calliope-mini/calliope-mini.github.io/README.md

# Technical Documentation

[see here](https://calliope-mini.github.io)
