calliope-mini/calliope-mini.github.io/hardware/v3.0/v30.md

---
layout: page
title: v3.0
permalink: v30/
navigation_weight: 2
---

## Allgemeines

Der Calliope mini 3 erhält nun schnellere Prozessoren, USB-C, 3 RGB-LED, einen besseren Motortreiber, Jacdac Konnektoren, sowie eine Pinleite.

### Technische Spezifikation  
  
* [Nordic nRF52833](https://www.nordicsemi.com/Products/nRF52833) Multi-protocol Bluetooth® low energy/2.4GHz RF SoC
    + 64MHZ ARM Cortex M4
    + 128kB RAM
    + 512kB Flash
    + Bluetooth Low Energy 5.4
* [Nordic nRF52820](https://www.nordicsemi.com/Products/nRF52820)
* 5x5 LED Matrix Bildschirm  
* Beschleunigungssensor, Gyroskop, Magnetometer
* MEMS Mikrofon
* DC Motortreiber ([TI DRV8835](http://www.ti.com/product/DRV8835))
* Piezo-Lautsprecher (MLT-8530)
* 3 Programmierbare RGB-LED
* 2 programmierbare Taster
* Serielle Schnittstelle (USB + konfigurierbare Anschlüsse)
* 2 Jacdac Konnektoren
* PWM Ausgabe
* 4 ansteckbare Laborstecker-Pins (Bananenstecker-/Krokodilklemmenanschlüsse)
* SPI + I2C
* USB-C Anschluss (Programmierung und Stromversorgung)
* 2x15 Pinleiste (2,54mm Lochraster)
* JST PH 2.0 Batterieanschluss (3.3V)
* Bananen-/Krokodilklemmenanschluss für 3.3V (Ausgang)
* 2 [Grove](http://wiki.seeed.cc/Grove_System/) Steckverbinder (I2C + Seriell/Analog)

### Software

#### Quellen und Entwicklungsumgebungen

- [Software Repository](https://github.com/calliope-edu){:target="_blank"}, enthält die offiziellen Calliope mini Softwareprojekte.
- MakeCode ([online Entwicklungsumgebung](https://makecode.calliope.cc))
- Python ([online Entwicklungsumgebung](https://python.calliope.cc))

### Pinbelegung

Pinbelegung (https://calliope.cc/media/pages/calliope-mini/technische-daten/6b2510621e-1695728195/calliopev3_front.svg){:target="_blank"}

### Schaltplan

[PDF](../assets/v30/img/Calliope_mini_3.pdf){:target="_blank"}

[License](../assets/img/calliope_license.png)
