calliope-mini/calliope-mini.github.io/index.md

---
layout: home
permalink: index.html
navigation_weight: 0
---
# CALLIOPE MINI

Der [Calliope mini](https://calliope.cc) ist eine für die Schule entwickelte Lernplattform.

Auf dieser Seite werden vorrangig technische Informationen zum Projekt bereitgestellt.
Sonstige Informationen, wie Materialien, Kontakt etc. finden sich unter [calliope.cc](https://calliope.cc).

Calliope
