calliope-mini/calliope-mini.github.io/hardware/v2.1/v21.md

---
layout: page
title: v2.1
permalink: v21/
navigation_weight: 2
---

## Allgemeines

Aufgrund der veränderten Verfügbarkeit von Bauteilen, wurden an der Version 2.0 geringe Hardwareveränderungen vorgenommen. Diese überarbeitete Version trägt die Nummer 2.1.
Die Arbeitsweise und der Funktionsumfang zur Version 2.0 haben sich nicht geändert.

### Technische Spezifikation  
  
* [Nordic nRF51822](https://www.nordicsemi.com/eng/Products/Bluetooth-low-energy/nRF51822) Multi-protocol Bluetooth® 4.0 low energy/2.4GHz RF SoC
    + 32-bit ARM Cortex M0 processor (16MHz)
    + 32kB RAM
    + 256kB Flash
    + Bluetooth Low Energy 
* [Raspberry Pi RP2040](https://www.raspberrypi.com/products/rp2040/) Dual-core Arm Cortex-M0+ Prozessor, mit bis zu 133MHz
* Flash Speicher 128Mb, 166MHZ ([ISSI IS25LP](http://www.issi.com/WW/pdf/25LP-WP128F.pdf)), frei bespielbar und ohne angeschlossenen Computer nutzbar
* 5x5 LED Matrix Bildschirm  
* Beschleunigungssensor, Gyroskop, Magnetometer ([Bosch BMX055](https://www.bosch-sensortec.com/bst/products/all_products/bmx055))
* MEMS Mikrofon
* DC Motortreiber ([TI DRV8837](http://www.ti.com/product/DRV8837))
* Piezo-Lautsprecher (MLT-8530)
* Programmierbare RGB LED ([WS2812b](https://cdn-shop.adafruit.com/datasheets/WS2812B.pdf))
* 2 programmierbare Taster
* Serielle Schnittstelle (USB + konfigurierbare Anschlüsse)
* PWM Ausgabe
* 4 ansteckbare Laborstecker-Pins (Bananenstecker-/Krokodilklemmenanschlüsse)
* 4 Analoge Eingänge
* 8-11 Ein-/Ausgangsanschlüsse (je nach Softwarekonfiguration)
* SPI + I2C
* USB Micro B Anschluss (Programmierung und Stromversorgung)
* JST PH 2.0 Batterieanschluss (3.3V)
* Bananen-/Krokodilklemmenanschluss für 3.3V (Ausgang)
* 2 [Grove](http://wiki.seeed.cc/Grove_System/) Steckverbinder (I2C + Seriell/Analog)

### Software

#### Quellen und Entwicklungsumgebungen

- [Software Repository](https://github.com/calliope-mini){:target="_blank"}, enthält die offiziellen Calliope mini Softwareprojekte.
- [OpenRoberta](https://github.com/OpenRoberta) ([online Entwicklungsumgebung](https://lab.open-roberta.org/))
- MakeCode ([online Entwicklungsumgebung](https://makecode.calliope.cc))

#### Standard Firmware

* [Firmware](https://github.com/calliope-mini/calliope-demo/releases/tag/3.1.0), Software, die sich im Auslieferungszustand auf
dem Gerät befindet.

### Pinbelegung

Pinbelegung{:target="_blank"}

### Blockschaltbild

Blockschaltbild Calliope mini v1.0{:target="_blank"}

### Schaltplan

[PDF](../assets/v21/img/Calliope mini rev2.1.pdf){:target="_blank"}, 
PNG ([Seite 1](../assets/v21/img/Calliope mini rev2.1.png){:target="_blank"}, [Seite 2](../assets/v21/img/Calliope mini rev2.1-2.png){:target="_blank"}),
(Eagle [SCH](../assets/v21/eagle/Calliope mini rev2.1.sch), [BRD](../assets/v21/eagle/Calliope mini rev2.1.brd))

Schaltplan Calliope mini v2.1 (Seite 1){:target="_blank"}
Schaltplan Calliope mini v2.1 (Seite 2){:target="_blank"}

[License](../assets/img/calliope_license.png)
