calliope-mini/calliope-mini.github.io/hardware/v1.0/v10.md

---
layout: page
title: v1.3
permalink: v10/
navigation_weight: 2
---

## Allgemeines

Die Revision 1.3 ist eine überarbeitete Version des Calliope mini. Wichtige Änderungen sind der Austausch 
der Taster mit den Grove Anschlüssen, so dass diese besser bedient werden können. Ausserdem wurden auf den
Grove Anschlüssen zwei Analoge Eingänge verfügbar gemacht. Zusätzlich wurde eine verbesserter Schutz gegen
elektrostatische Entladung eingebracht. Der Logoaufdruck befindet sich hier auf der linken Seite
der Platine auf der Antenne. Mit der v1.3 wurde eine weitere Masseleitung zum Motorport hinzugefügt und die 
Stromversorgung so aktualisiert, dass Batterie und USB bei gleichzeitigem Anschluss getrennt sind.

### Technische Spezifikation  
  
* [Nordic nRF51822](https://www.nordicsemi.com/eng/Products/Bluetooth-low-energy/nRF51822) Multi-protocol Bluetooth® 4.0 low energy/2.4GHz RF SoC
    + 32-bit ARM Cortex M0 processor (16MHz)
    + 16kB RAM
    + 256kB Flash
    + Bluetooth Low Energy 
* 5x5 LED Matrix Bildschirm  
* Beschleunigungssensor, Gyroskop, Magnetometer ([Bosch BMX055](https://www.bosch-sensortec.com/bst/products/all_products/bmx055))
* MEMS Mikrofon
* DC Motortreiber ([TI DRV8837](http://www.ti.com/product/DRV8837))
* Piezo-Lautsprecher
* Programmierbare RGB LED ([WS2812b](https://cdn-shop.adafruit.com/datasheets/WS2812B.pdf))
* 2 programmierbare Taster
* Serielle Schnittstelle (USB + konfigurierbare Anschlüsse)
* PWM Ausgabe
* 4 Bananenstecker-/Krokodilklemmenanschlüsse
* 4 Analoge Eingänge
* 8-11 Ein-/Ausgangsanschlüsse (je nach Softwarekonfiguration)
* SPI + I2C
* USB Micro B Anschluss (Programmierung und Stromversorgung)
* JST Batterieanschluss (3.3V)
* Bananen-/Krokodilklemmenanschluss für 3.3V (Ausgang)
* 2 [Grove](http://wiki.seeed.cc/Grove_System/) Steckverbinder (I2C + Seriell/Analog)
* [NXP KL26z](http://www.nxp.com/products/microcontrollers-and-processors/arm-processors/kinetis-cortex-m-mcus/l-series-ultra-low-power-m0-plus/kinetis-kl2x-48-mhz-usb-ultra-low-p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) (USB und Stromversorgung)
* Flash-Programmspeicher (optional)

### Software

#### Quellen und Entwicklungsumgebungen

- [Software Repository](https://github.com/calliope-mini){:target="_blank"}, enthält die offiziellen Calliope mini Softwareprojekte.
- [OpenRoberta](https://github.com/OpenRoberta) ([online Entwicklungsumgebung](https://lab.open-roberta.org/))
- MakeCode ([online Entwicklungsumgebung](https://pxt.calliope.cc))

#### Standard Firmware

* [Firmware](https://github.com/calliope-mini/calliope-demo/releases/tag/v2.0), Software, die sich im Auslieferungszustand auf
dem Gerät befindet.
* [Bootloader](https://github.com/calliope-mini/production-test/releases/tag/bootloader-r1.0), Software, die auf dem Interface-Chip
läuft und für den Fall aufgespielt wird, wenn sich der Calliope mini nicht mehr mit dem Laufwerk `MINI` anmeldet.

### Pinbelegung

Pinbelegung{:target="_blank"}

### Blockschaltbild

Blockschaltbild Calliope mini v1.0{:target="_blank"}

### Schaltplan

[PDF](../assets/v10/img/Calliope mini rev1.3.pdf){:target="_blank"}, 
PNG ([Seite 1](../assets/v10/img/Calliope mini rev1.3.png){:target="_blank"}, [Seite 2](../assets/v10/img/Calliope mini rev1.3-2.png){:target="_blank"}),
(Eagle [SCH](../assets/v10/eagle/Calliope mini rev1.3.sch), [BRD](../assets/v10/eagle/Calliope mini rev1.3.brd))

Schaltplan Calliope mini v1.3 (Seite 1){:target="_blank"}
Schaltplan Calliope mini v1.3 (Seite 2){:target="_blank"}

### Errata / Fehler

* Die Verbindung von Pin DEC2 und VCC führt zu erhöhtem Stress bei der Nordic nRF51 MCU, da damit der Chip auf 1.8V eingestellt wird. Dieser Fehler in der Schaltung wurde durch eine mechanische Trennung bei allen Geräten behoben, die ab der Crowdfunding Campagne ausgeliefert wurden. (**Ab Version > 1.0 behoben**)
* Die Mikrofonschaltung hat eine sehr geringe Verstärkung. Dieser Fehler wurde durch den Tausch eines Widerstands in der laufenden Produktion behoben. (**Ab Version > 1.0 behoben**) 
* Die Stromversorgung trennt nicht komplett, wenn Batterie und USB angeschlossen sind. Mit Version 1.3 behoben.
