calliope-mini/calliope-mini.github.io/assets/img/calliope_license.png

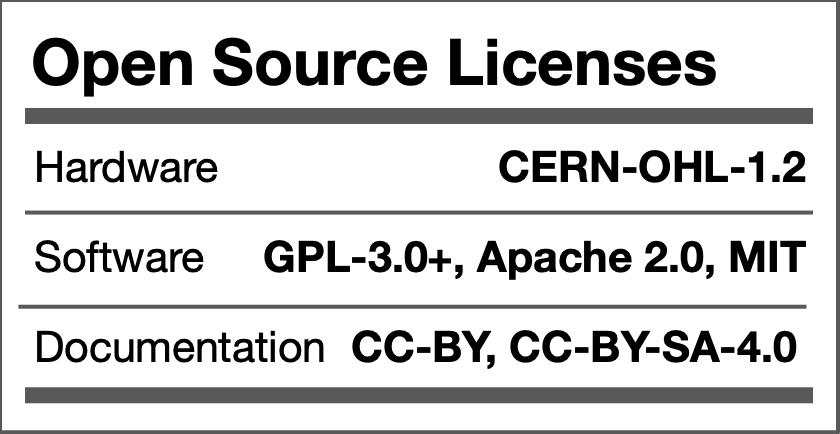
assets/img/calliope_license.png
