calliope-mini/calliope-mini.github.io/(threads)

Thread 1 (2017-04-25):

Preview enlargement not working

Portabella, 2017-04-25:
When I click on the preview enlargement button (Vollbildmodus) below the Calliope Simulator, it only enlarges the button, not the Calliope simulator itself.

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

Thread 2 (2017-04-25):

Shake button is very small

Portabella, 2017-04-25:
In the simulator the shake button is very small. In an older version it was larger and students were able to find it easier. Can you please make the button larger again?

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

Thread 3 (2017-04-25):

In Firefox on music keyboard the name of the note is not shown

Portabella, 2017-04-25:
Remark: Might be an issue only relevant in older versions of Firefox.

If I want to program a song, I do not see the name of the music note. It is not shown below the keyboard. It works in Chrome. See two images attached.
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

Thread 4 (2017-05-20):

Choose a license

Fluepke, 2017-05-20:
What is the license of this project?
Is this truly open source? Can I reuse your code and schematics for my own projects?

thinkberg, 2017-06-12:
The source code has the license individually attached. I will check that we attach a license to the info page as well.

nichtich, 2017-08-20:
Yes, please! Anything against CC0?

tatzelbrumm, 2017-11-05:
Do you have a license for the **hardware**?
Those need to be handled differently than software source code.
Maybe use one of the Open Hardware Licenses from the [Open Hardware Repository](https://www.ohwr.org/licenses), like, [CERN OHL v1.2](https://www.ohwr.org/licenses/cern-ohl/license_versions/v1.2)?

Thread 6 (2019-02-10):

fritzing part

el-j, 2019-02-10:
hej just to let you know:
there is now a fritzing part of the rev 1.3 board:
checkout https://github.com/fritzing/fritzing-parts/issues/171

maybe nice to link as well?
cheers
