calliope-mini/calliope-mini.github.io/assets/v21/img/Calliope mini rev2.1.pdf

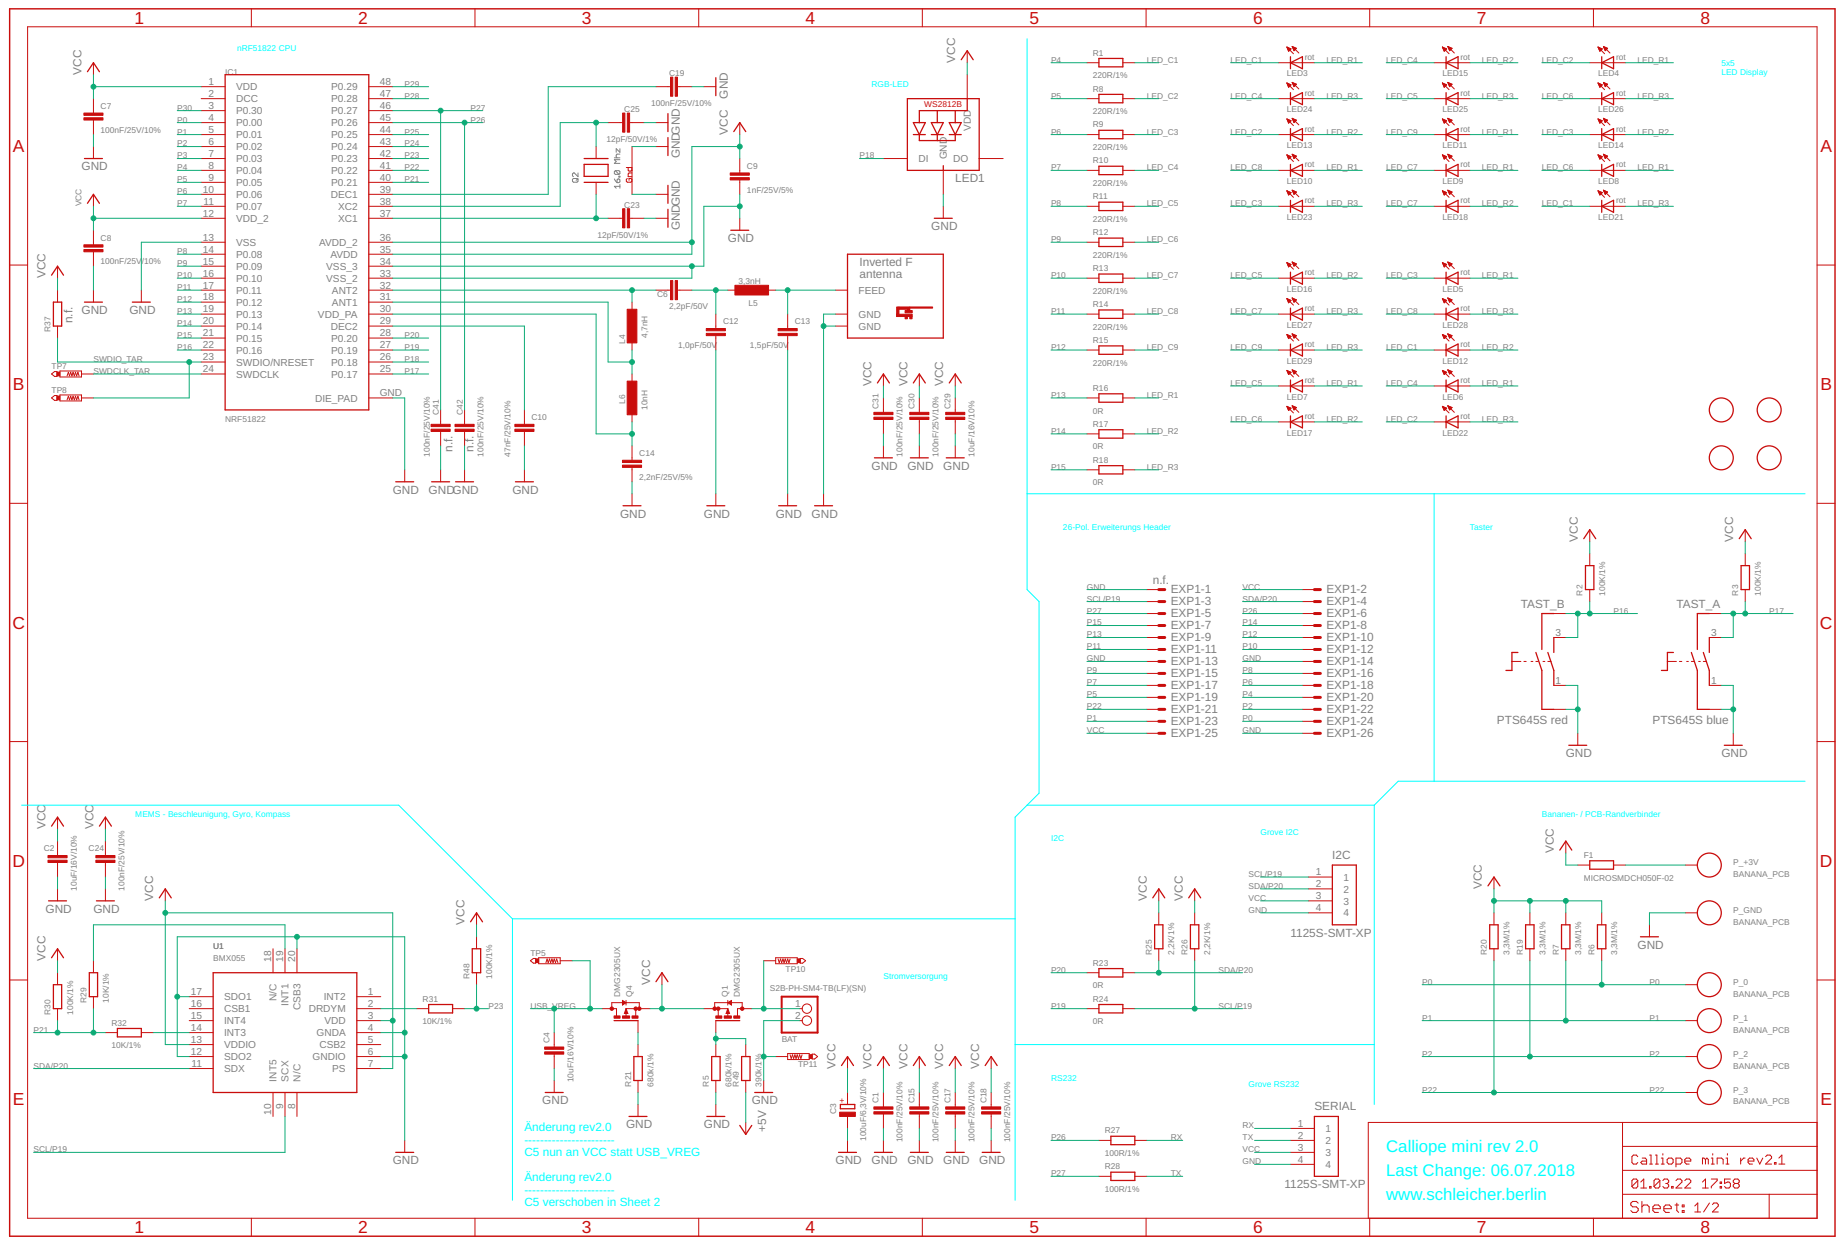
[picture p13: page 1]

MEMS - Beschleunigung, Gyro, Kompass

Änderung rev2.0
----------------------- C5 nun an VCC statt USB_VREG

Calliope mini rev 2.0
Last Change: 06.07.2018 www.schleicher.berlin

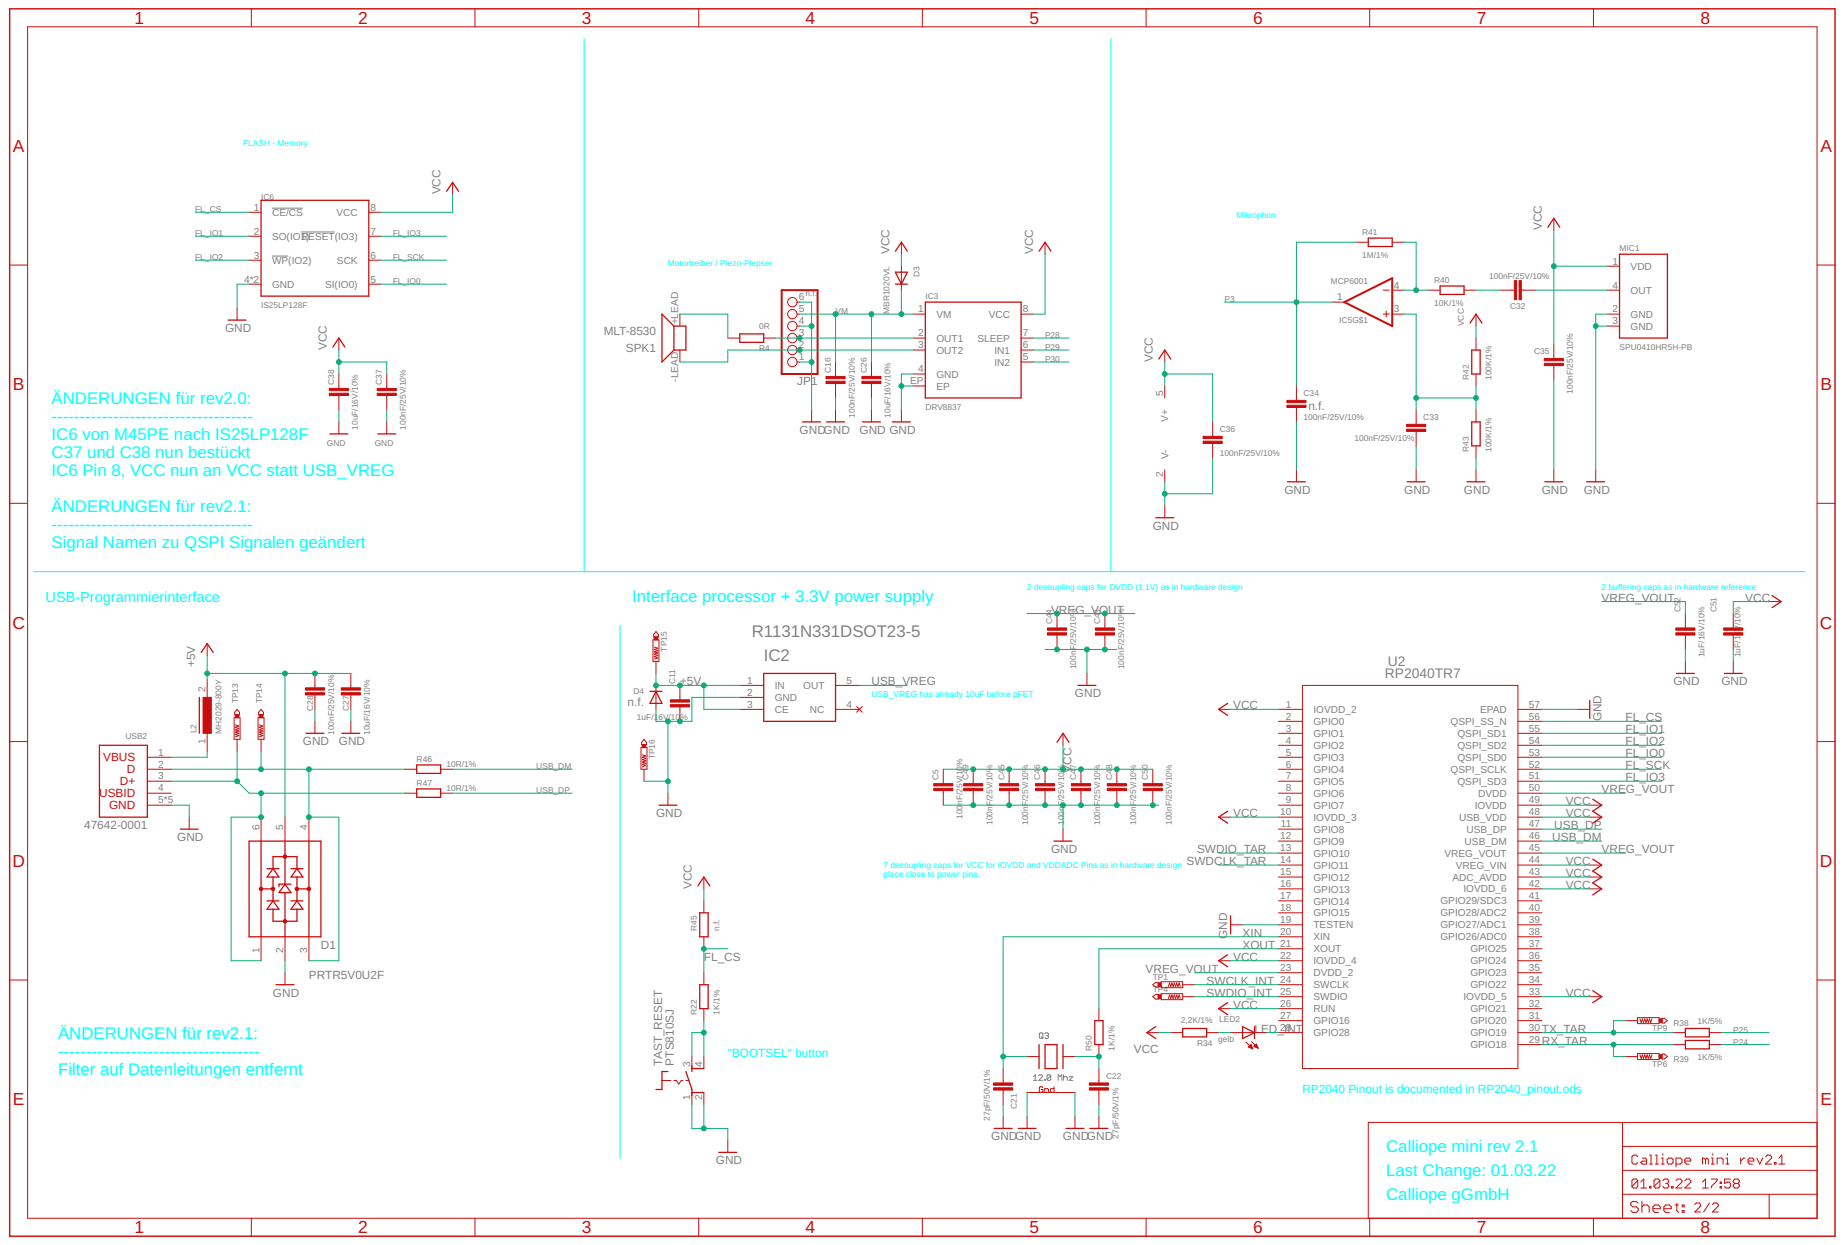
[picture p14: page 2]

VCC GND GND GND

ÄNDERUNGEN für rev2.0: ------------------------------------
IC6 von M45PE nach IS25LP128F
C37 und C38 nun bestückt
IC6 Pin 8, VCC nun an VCC statt USB_VREG
ÄNDERUNGEN für rev2.1: ------------------------------------ Signal Namen zu QSPI Signalen geändert

Interface processor + 3.3V power supply

2 decoupling caps for DVDD (1.1V) as in hardware design

2 buffering caps as in hardware reference

7 decoupling caps for VCC for IOVDD and VDDADC Pins as in hardware design
place close to power pins.

ÄNDERUNGEN für rev2.1: ------------------------------------ Filter auf Datenleitungen entfernt

RP2040 Pinout is documented in RP2040_pinout.ods
