calliope-mini/calliope-mini.github.io/assets/v20/img/Calliope mini rev2.0.pdf

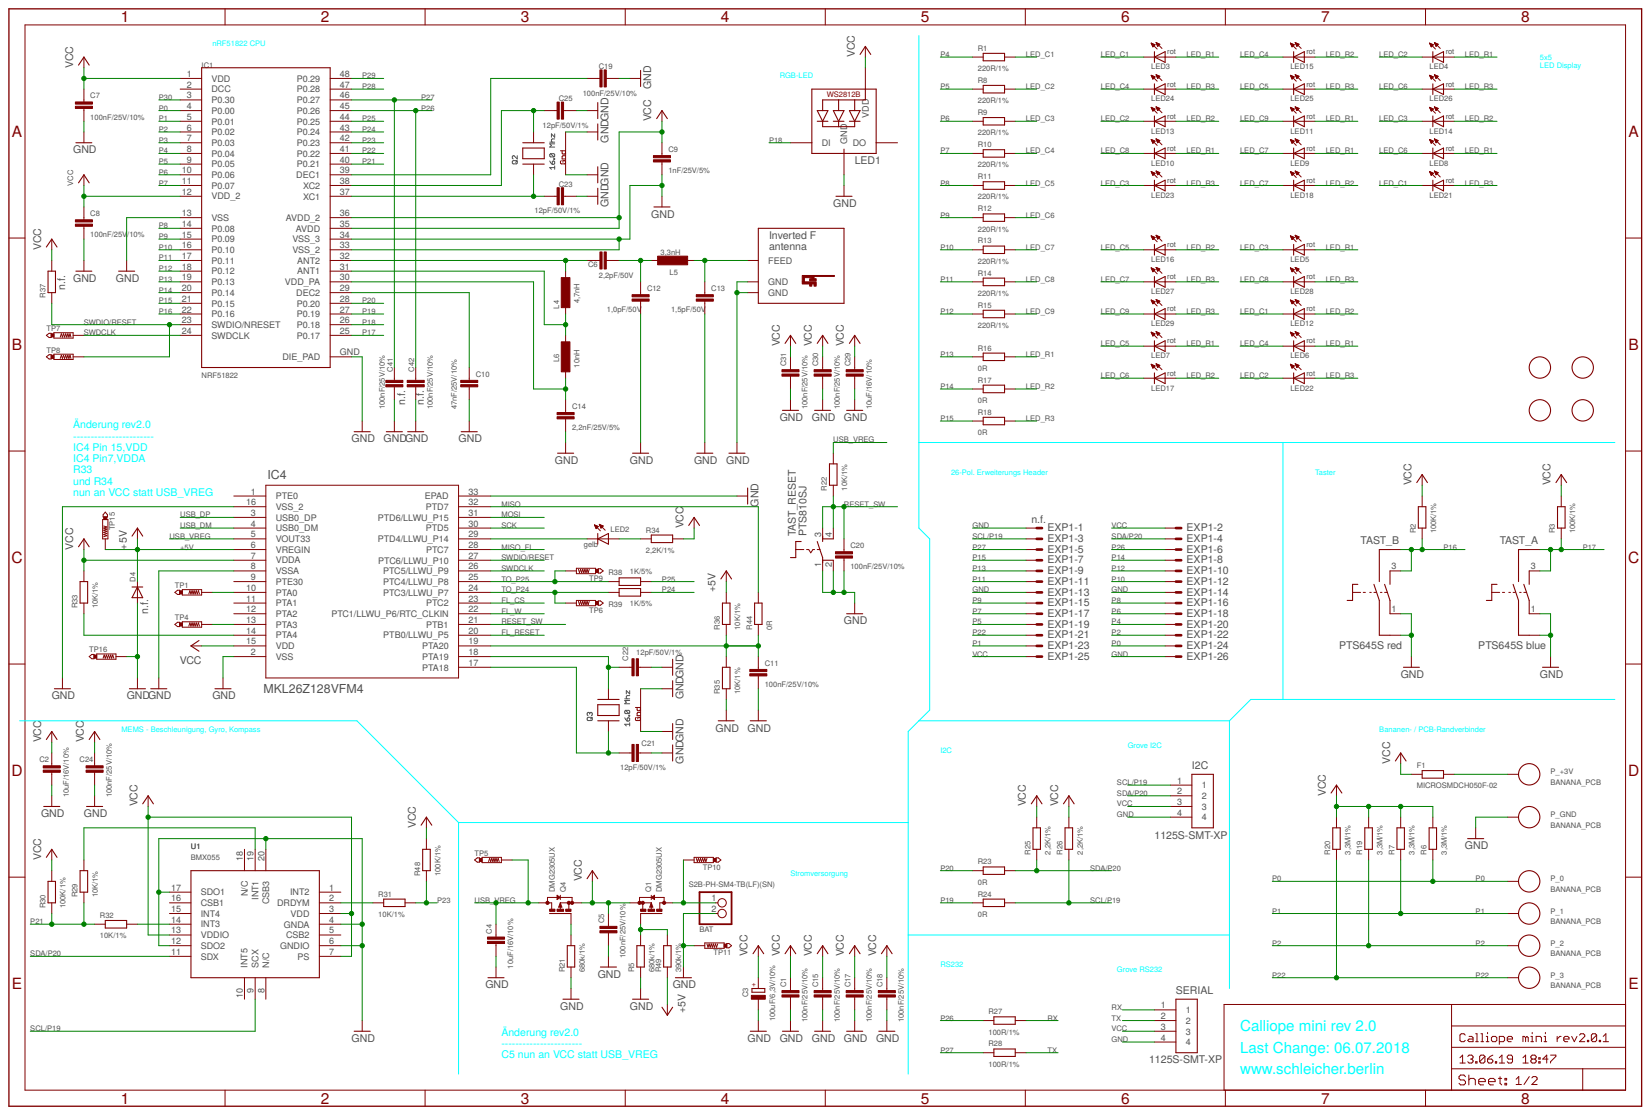
[picture p15: page 1]

MEMS - Beschleunigung, Gyro, Kompass

Änderung rev2.0
----------------------- C5 nun an VCC statt USB_VREG

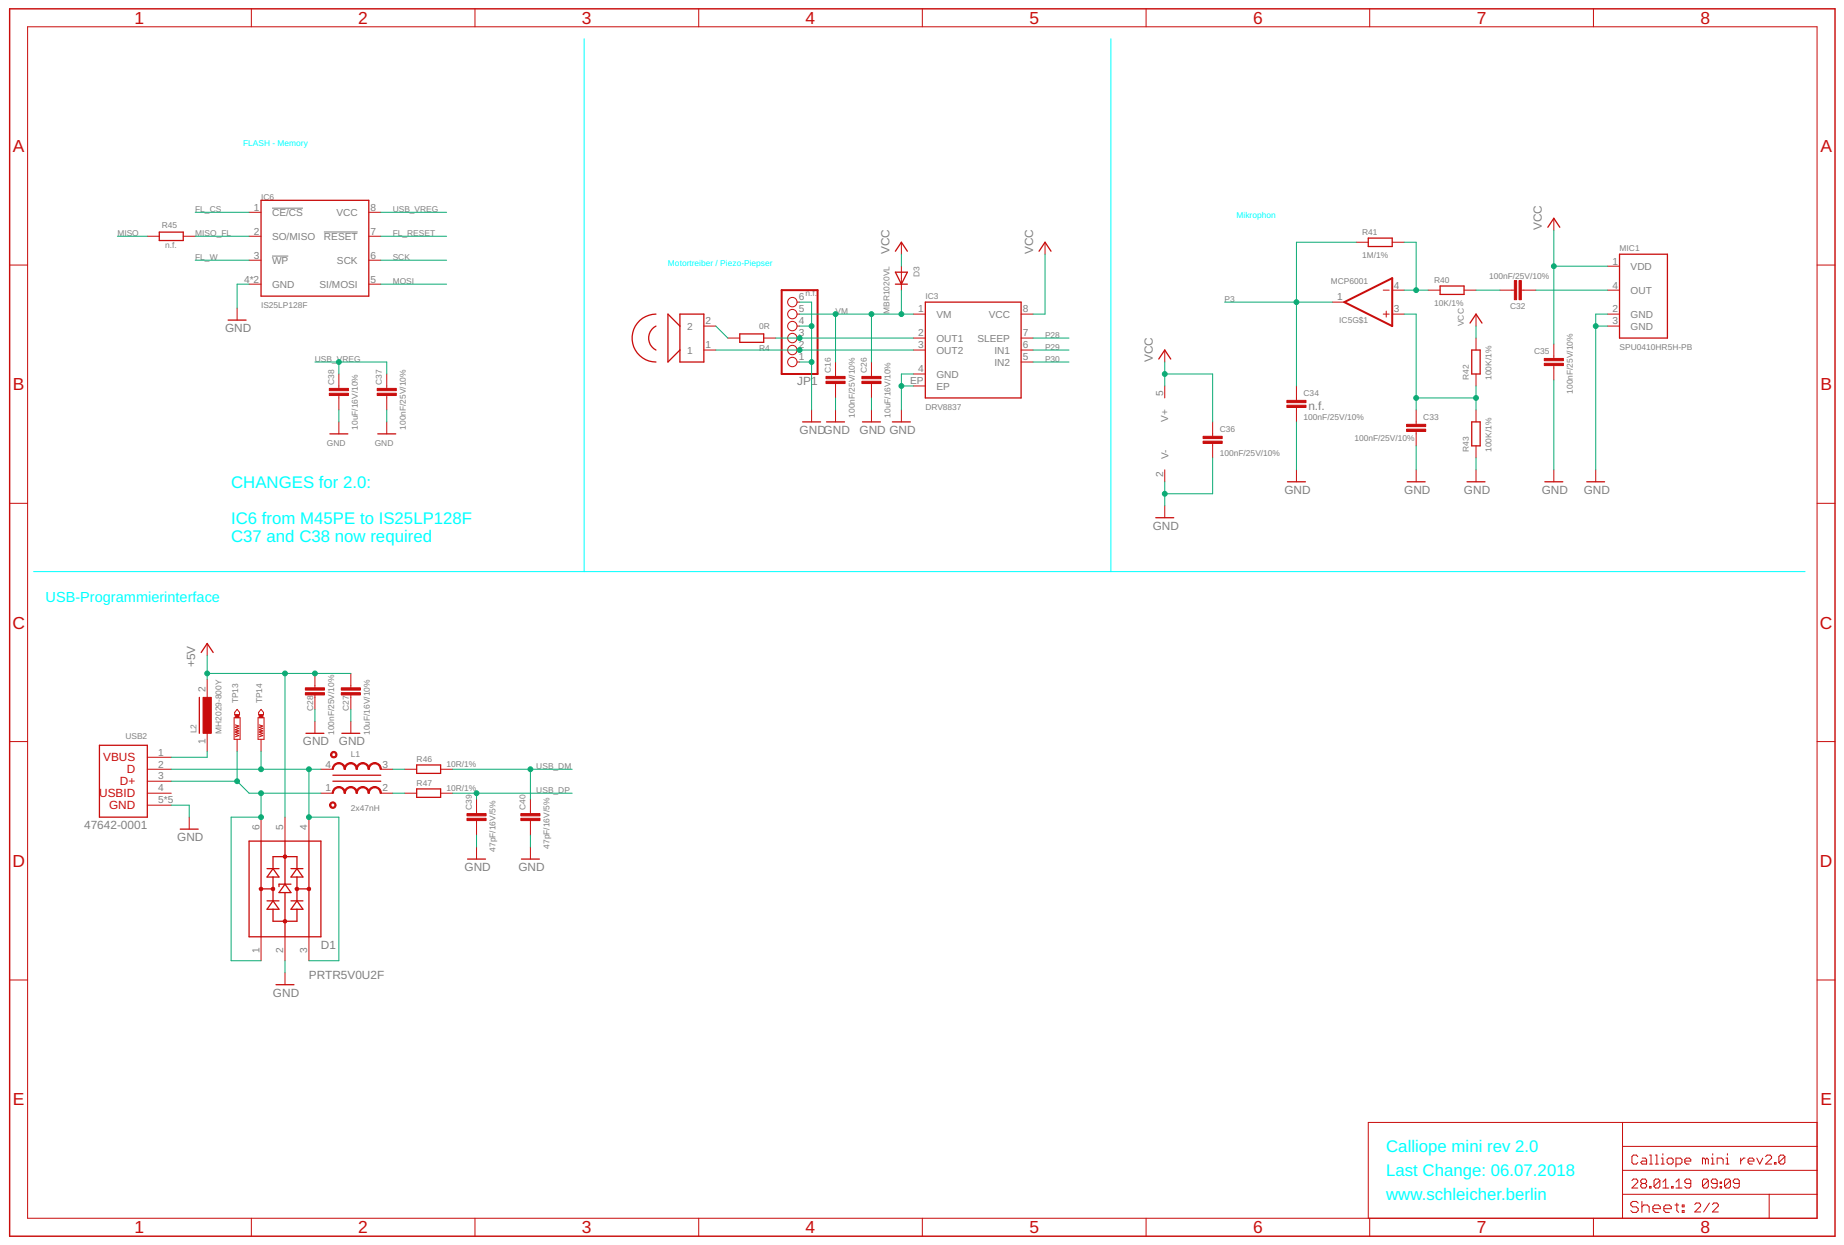
[picture p16: page 2]

VCC GND GND GND

Calliope mini rev 2.0
Last Change: 06.07.2018 www.schleicher.berlin
