calliope-mini/calliope-mini.github.io/assets/v10/img/Calliope mini rev1.3.pdf

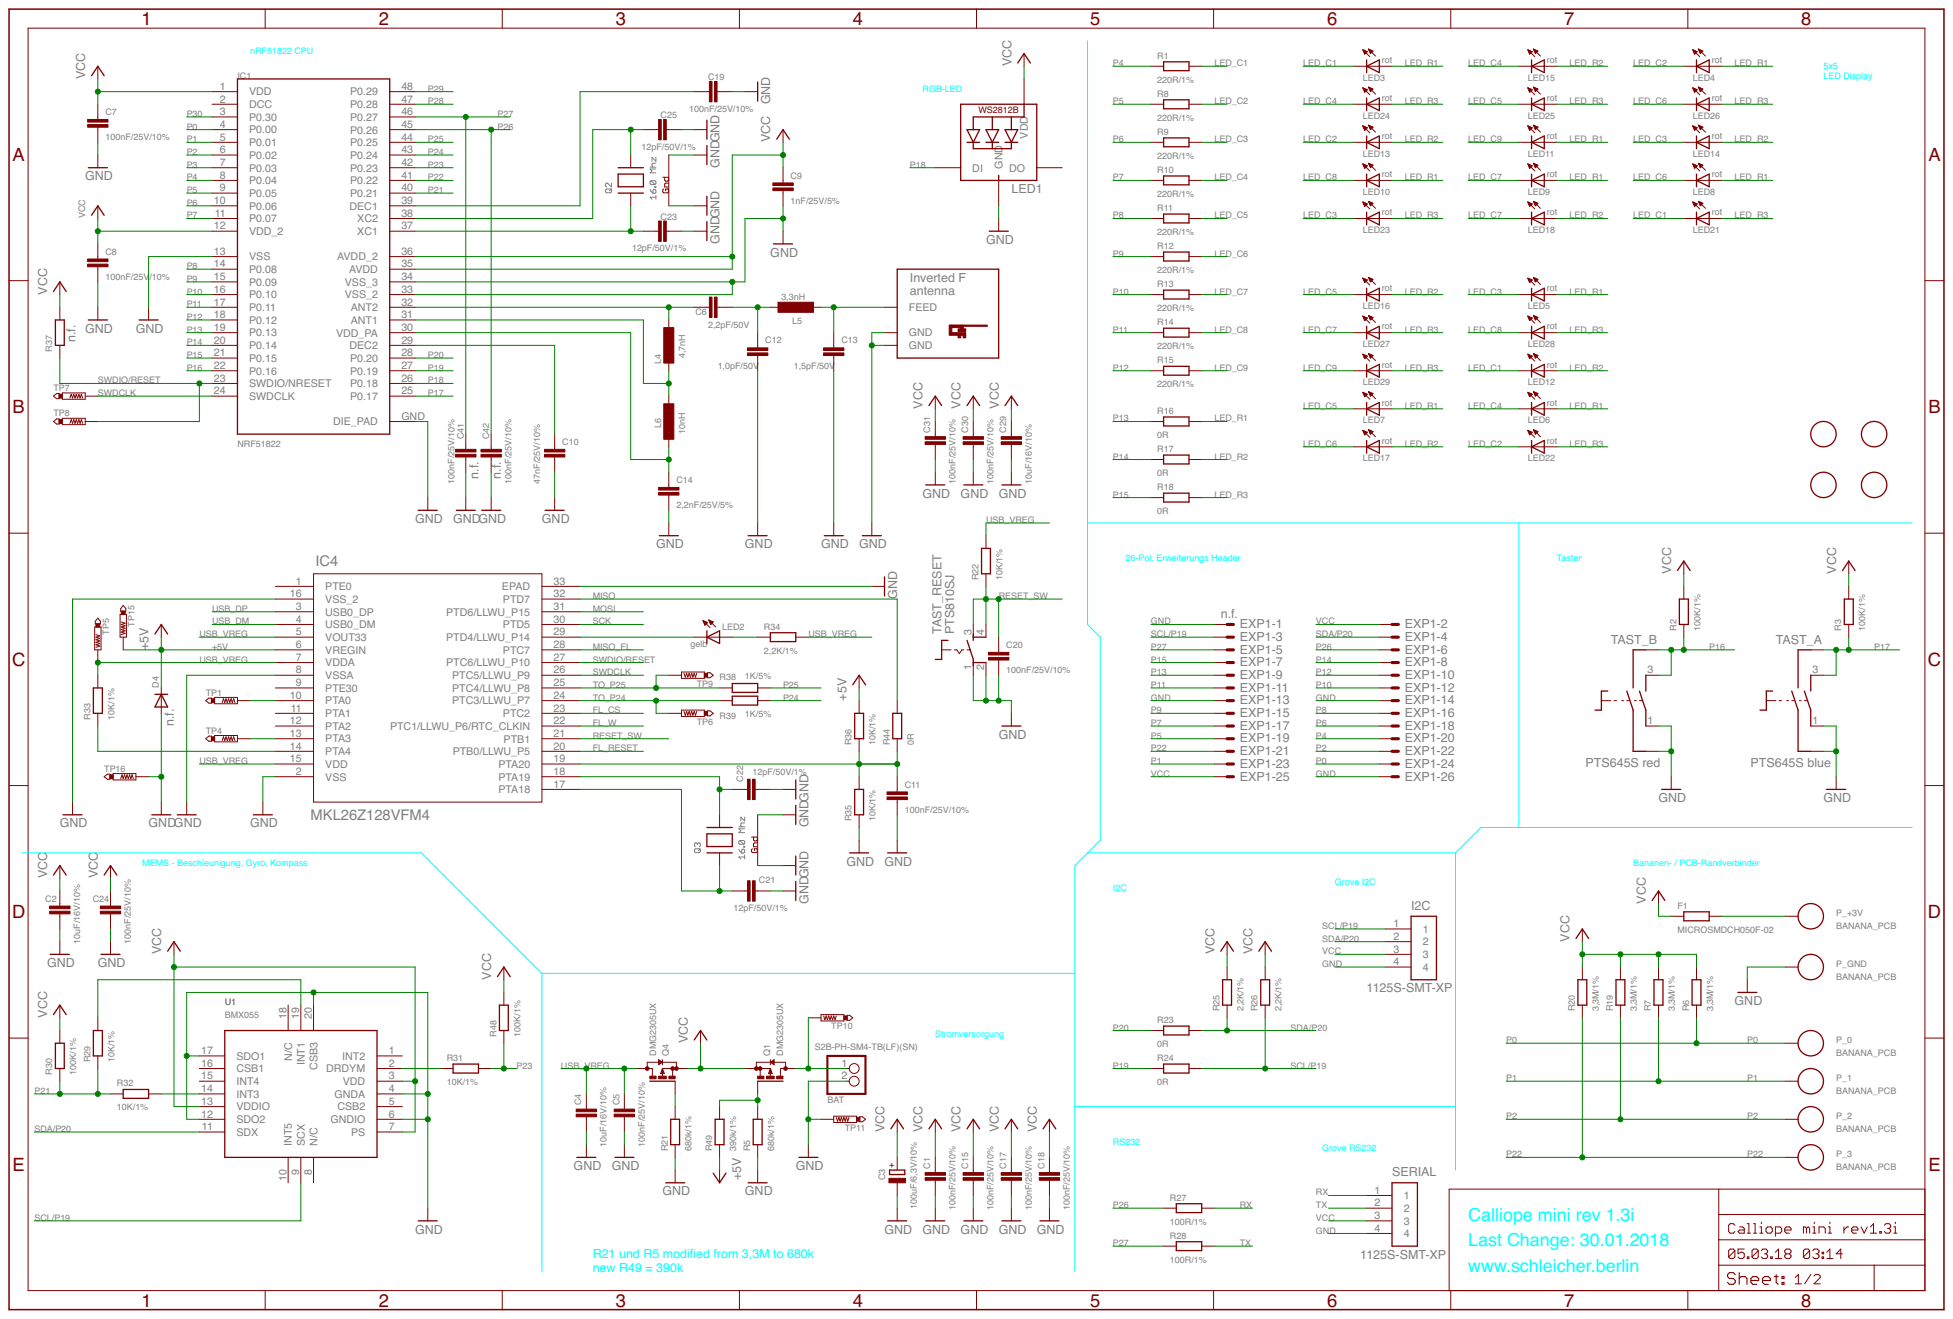
[picture p17: page 1]

8 | | 26 PTC6/LLWU_P10 SWDCLK
9 10 | | 25 PTC5/LLWU_P9

MEMS - Beschleunigung, Gyro, Kompass

R21 und R5 modified from 3,3M to 680k new R49 = 390k

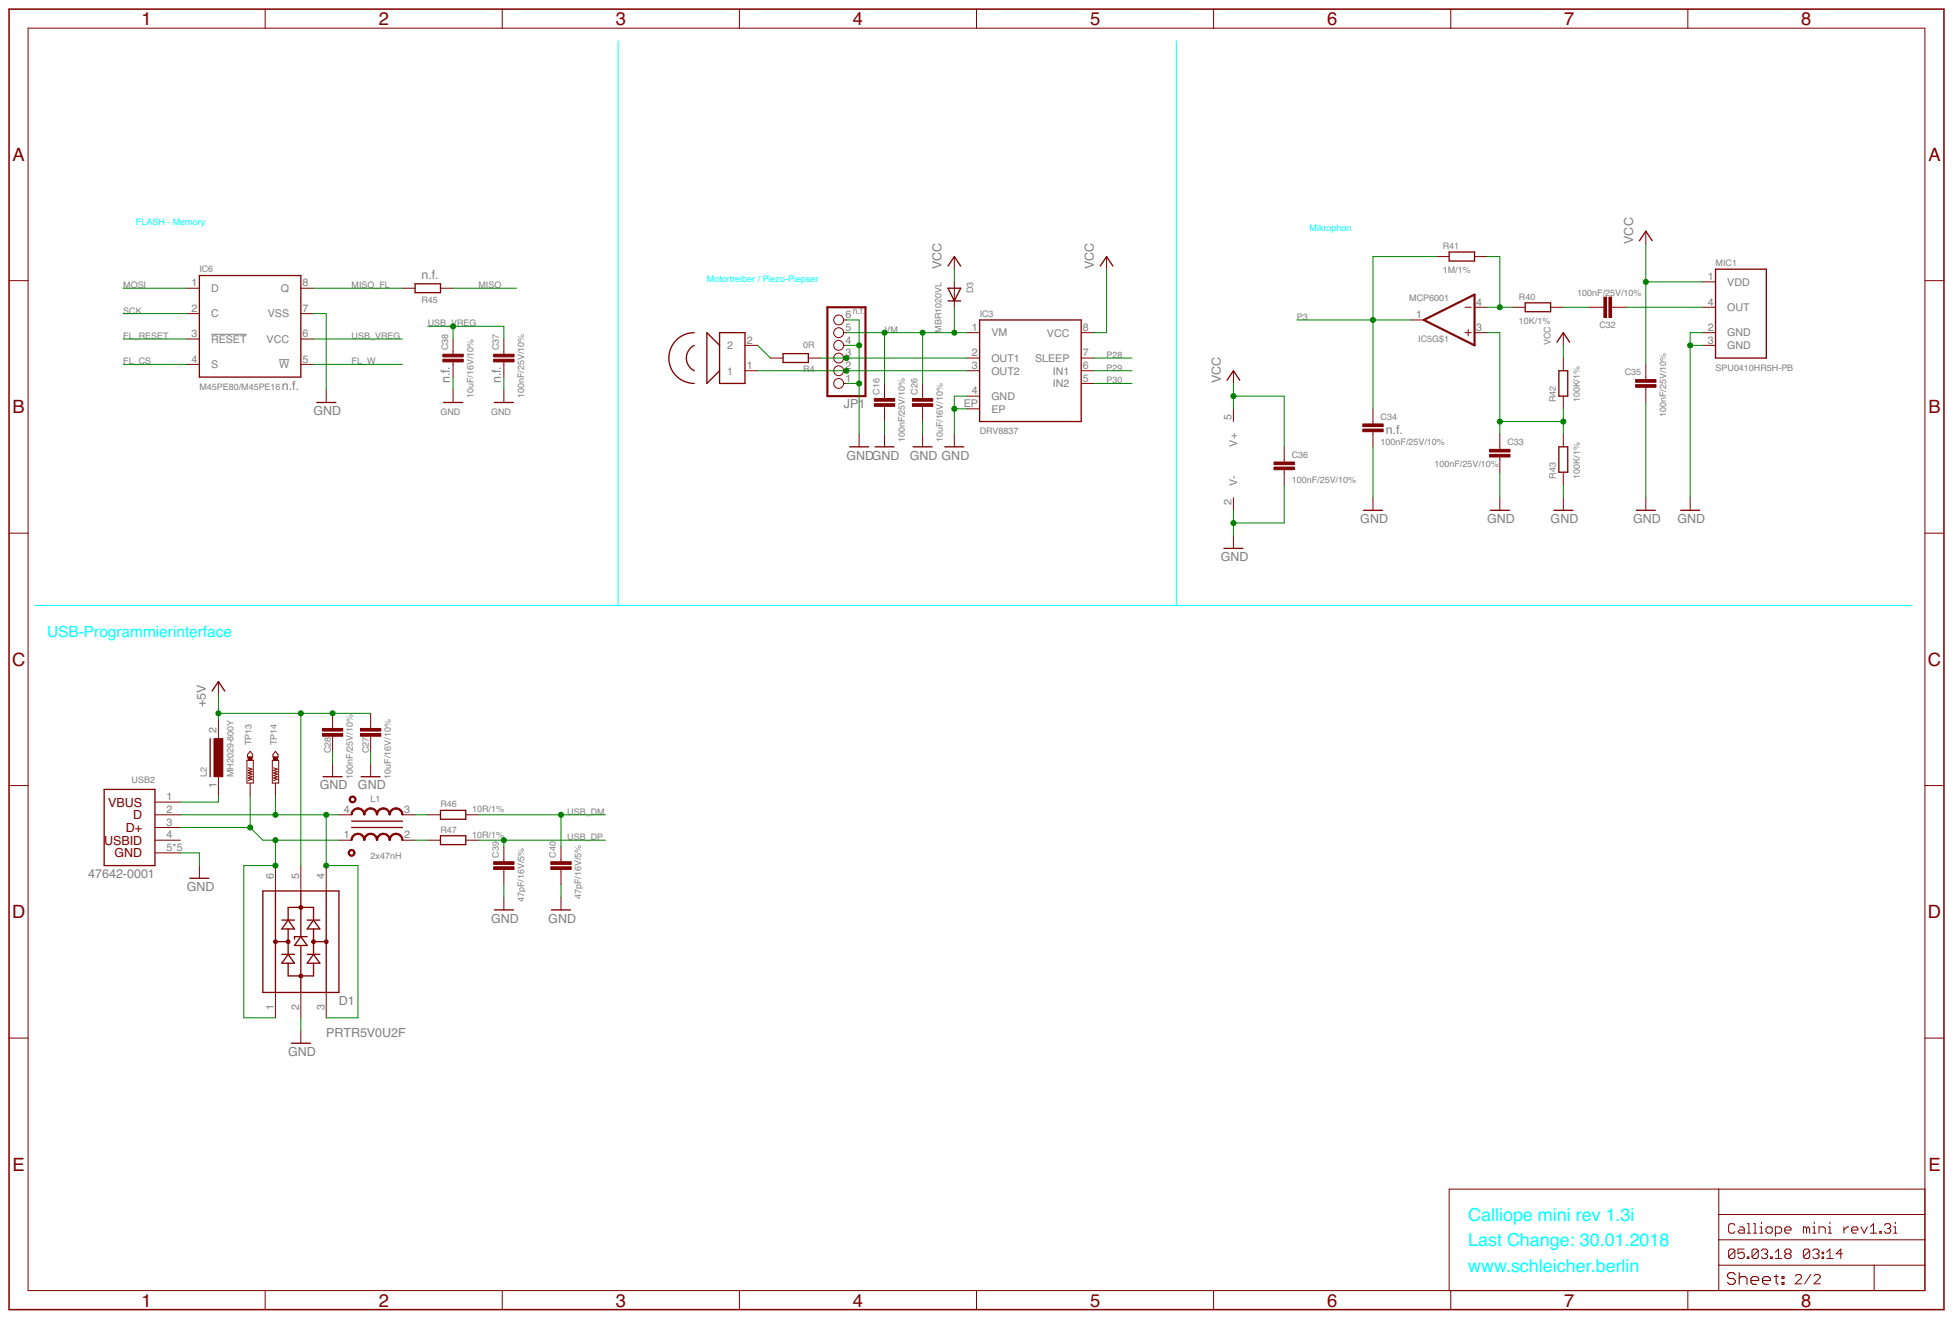
[picture p18: page 2]

VCC GND GND GND
