calliope-mini/calliope-mini.github.io/assets/v10/img/Calliope mini rev1.0.pdf

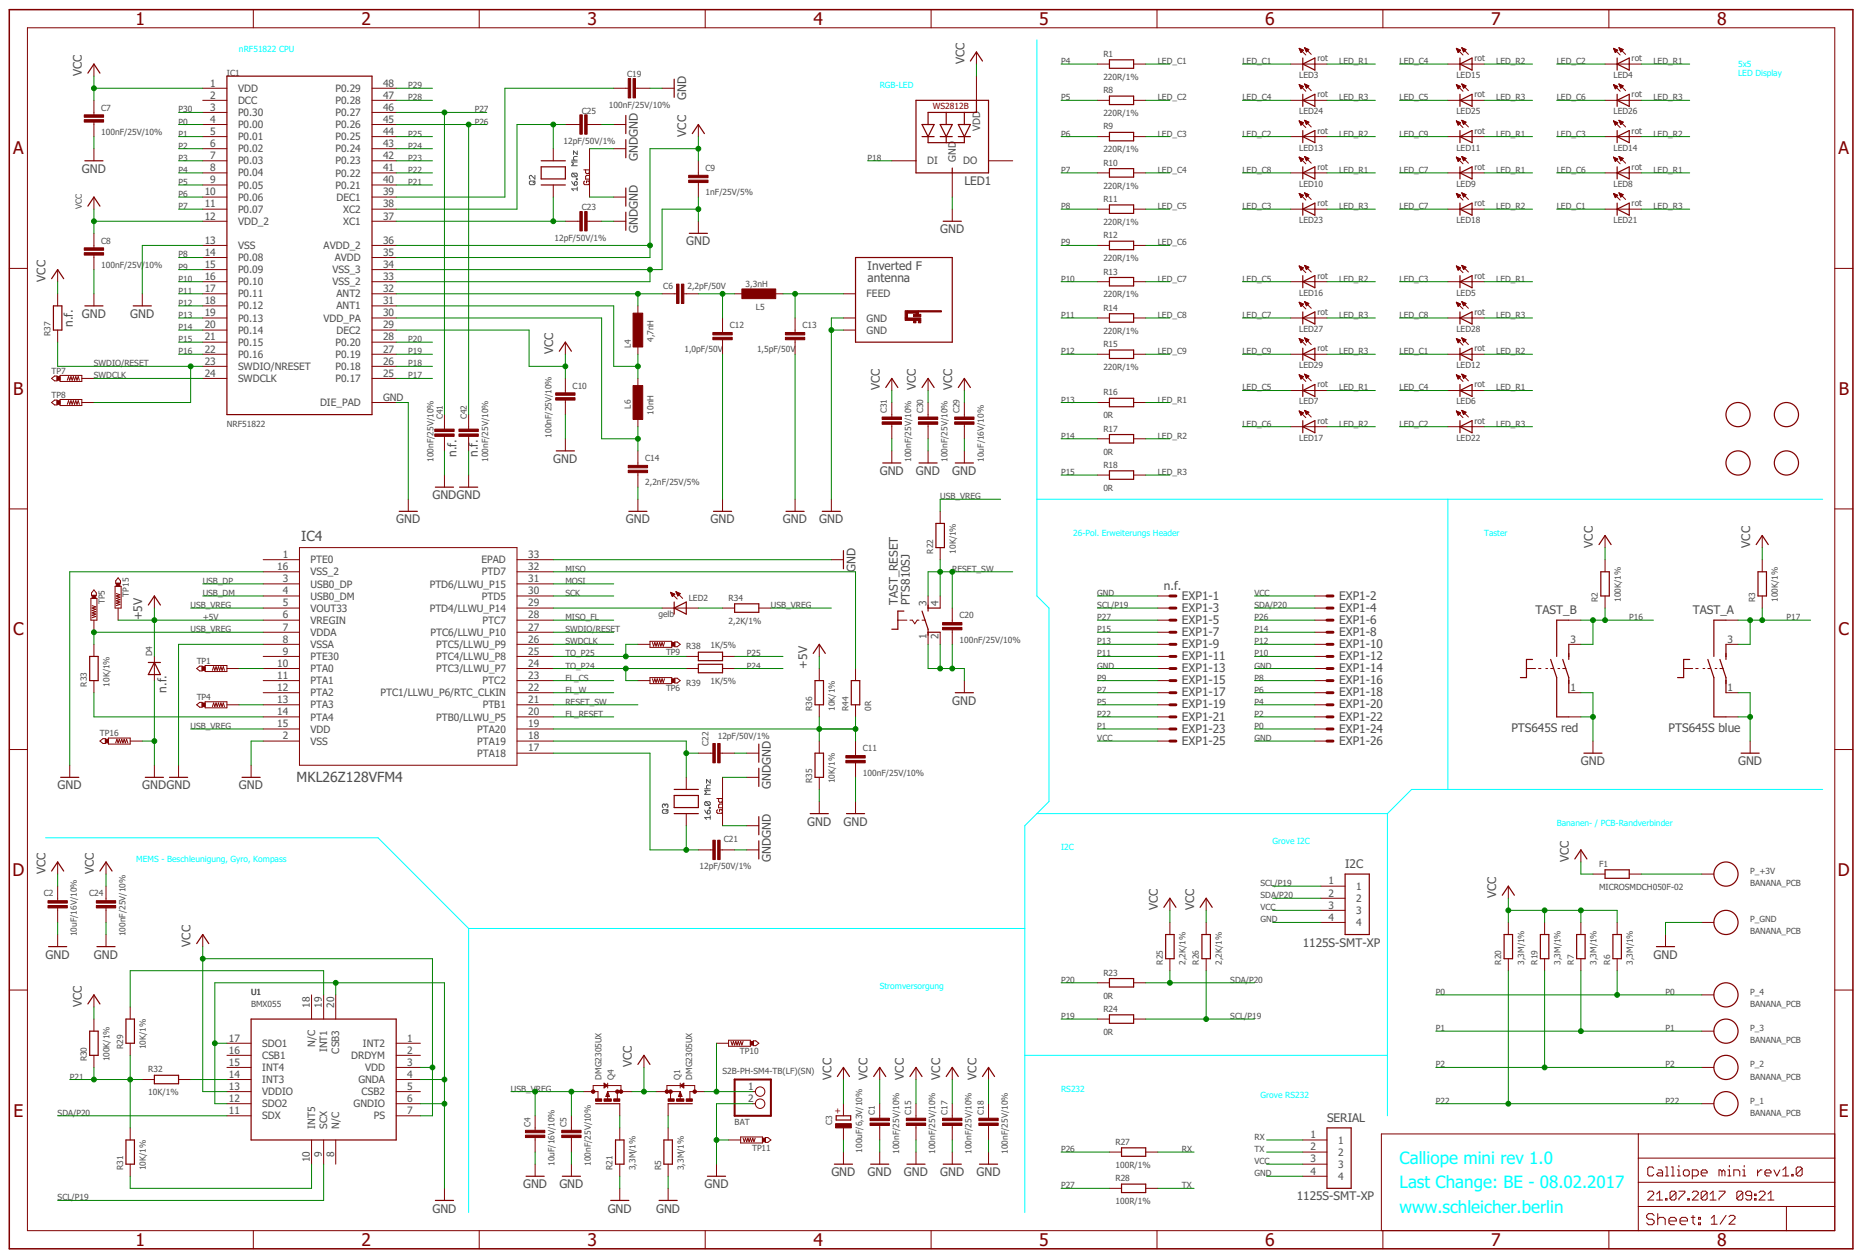
[picture p19: page 1]

MEMS - Beschleunigung, Gyro, Kompass

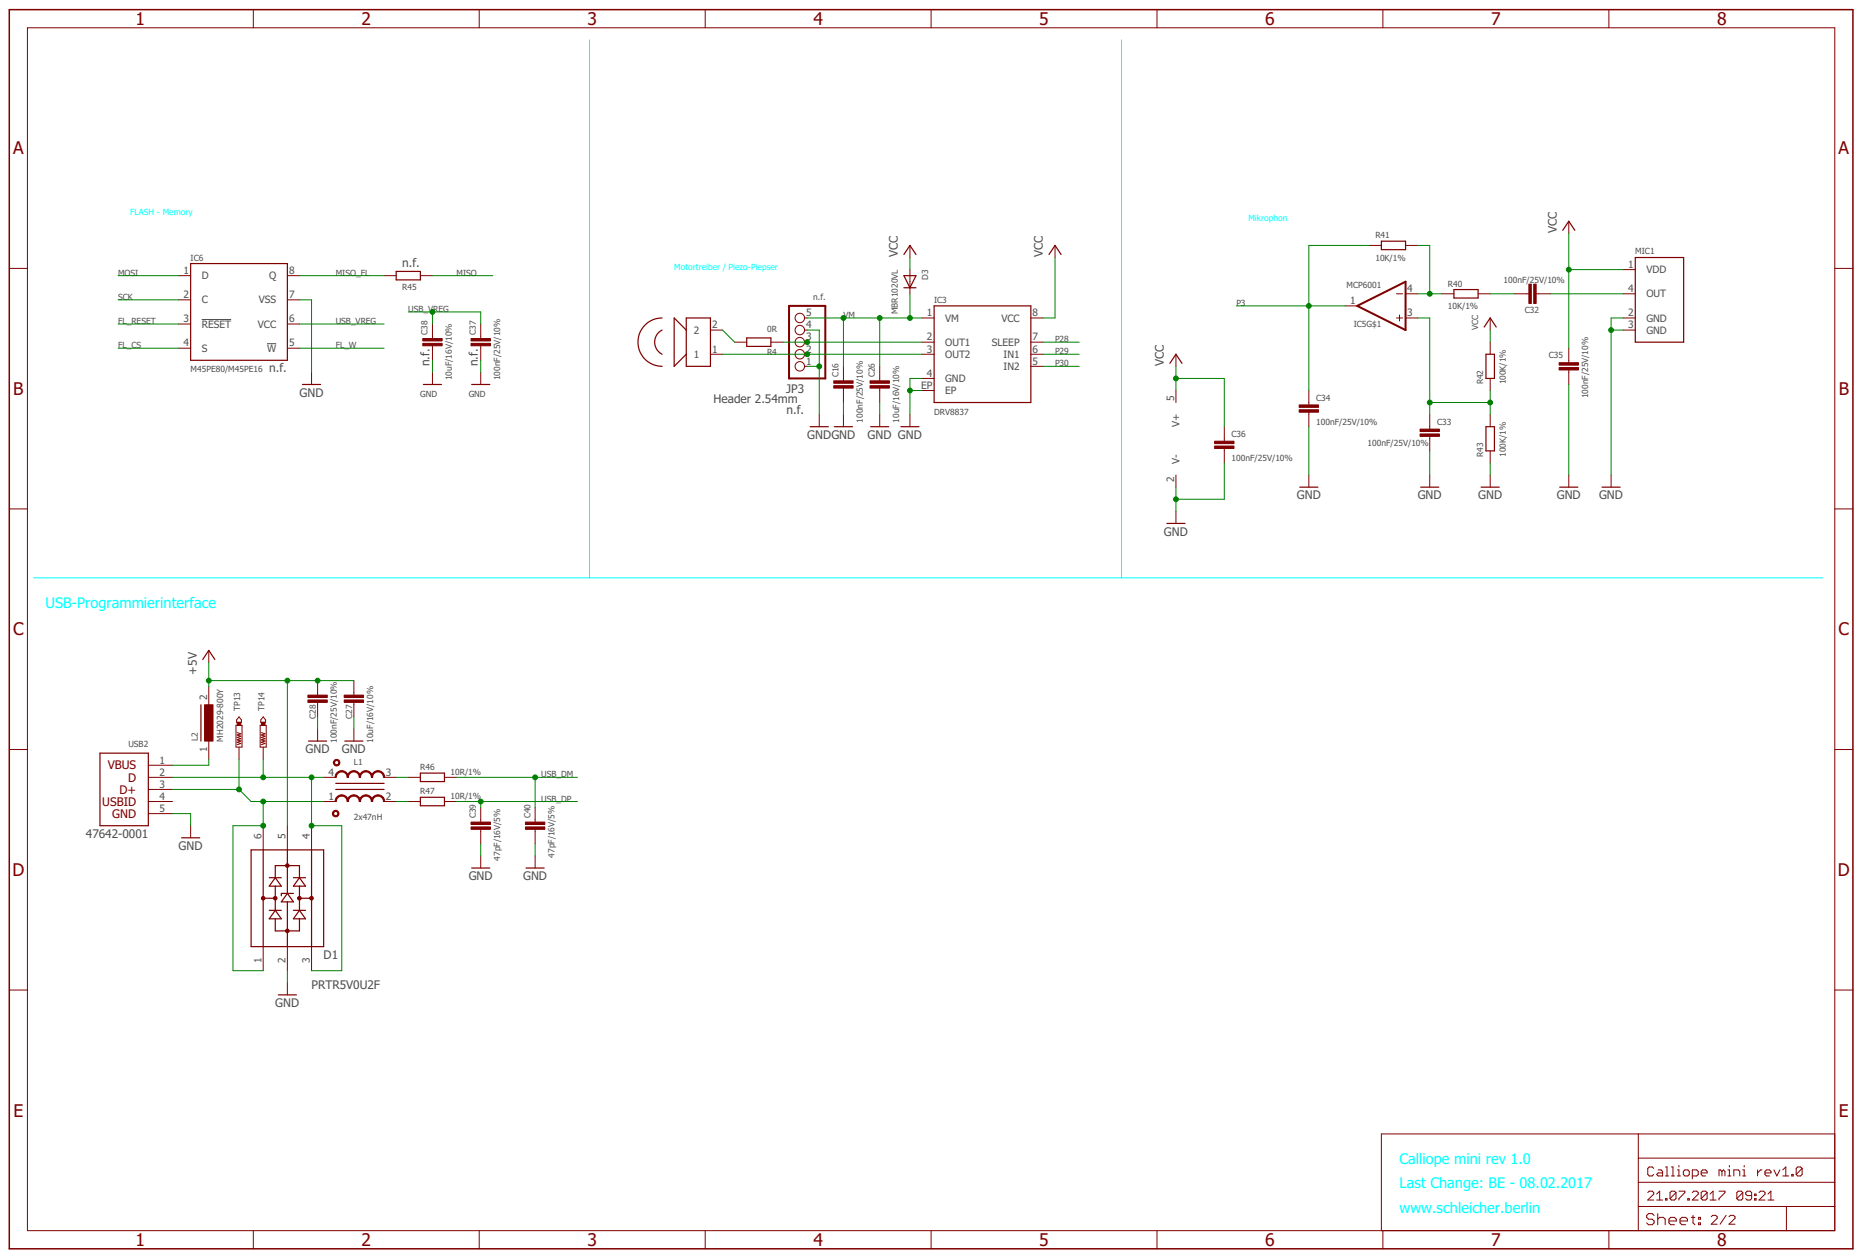
[picture p20: page 2]

VCC GND GND GND
