calliope-mini/calliope-mini.github.io/assets/v03/img/Calliope mini rev0.3.3_gipfel.pdf

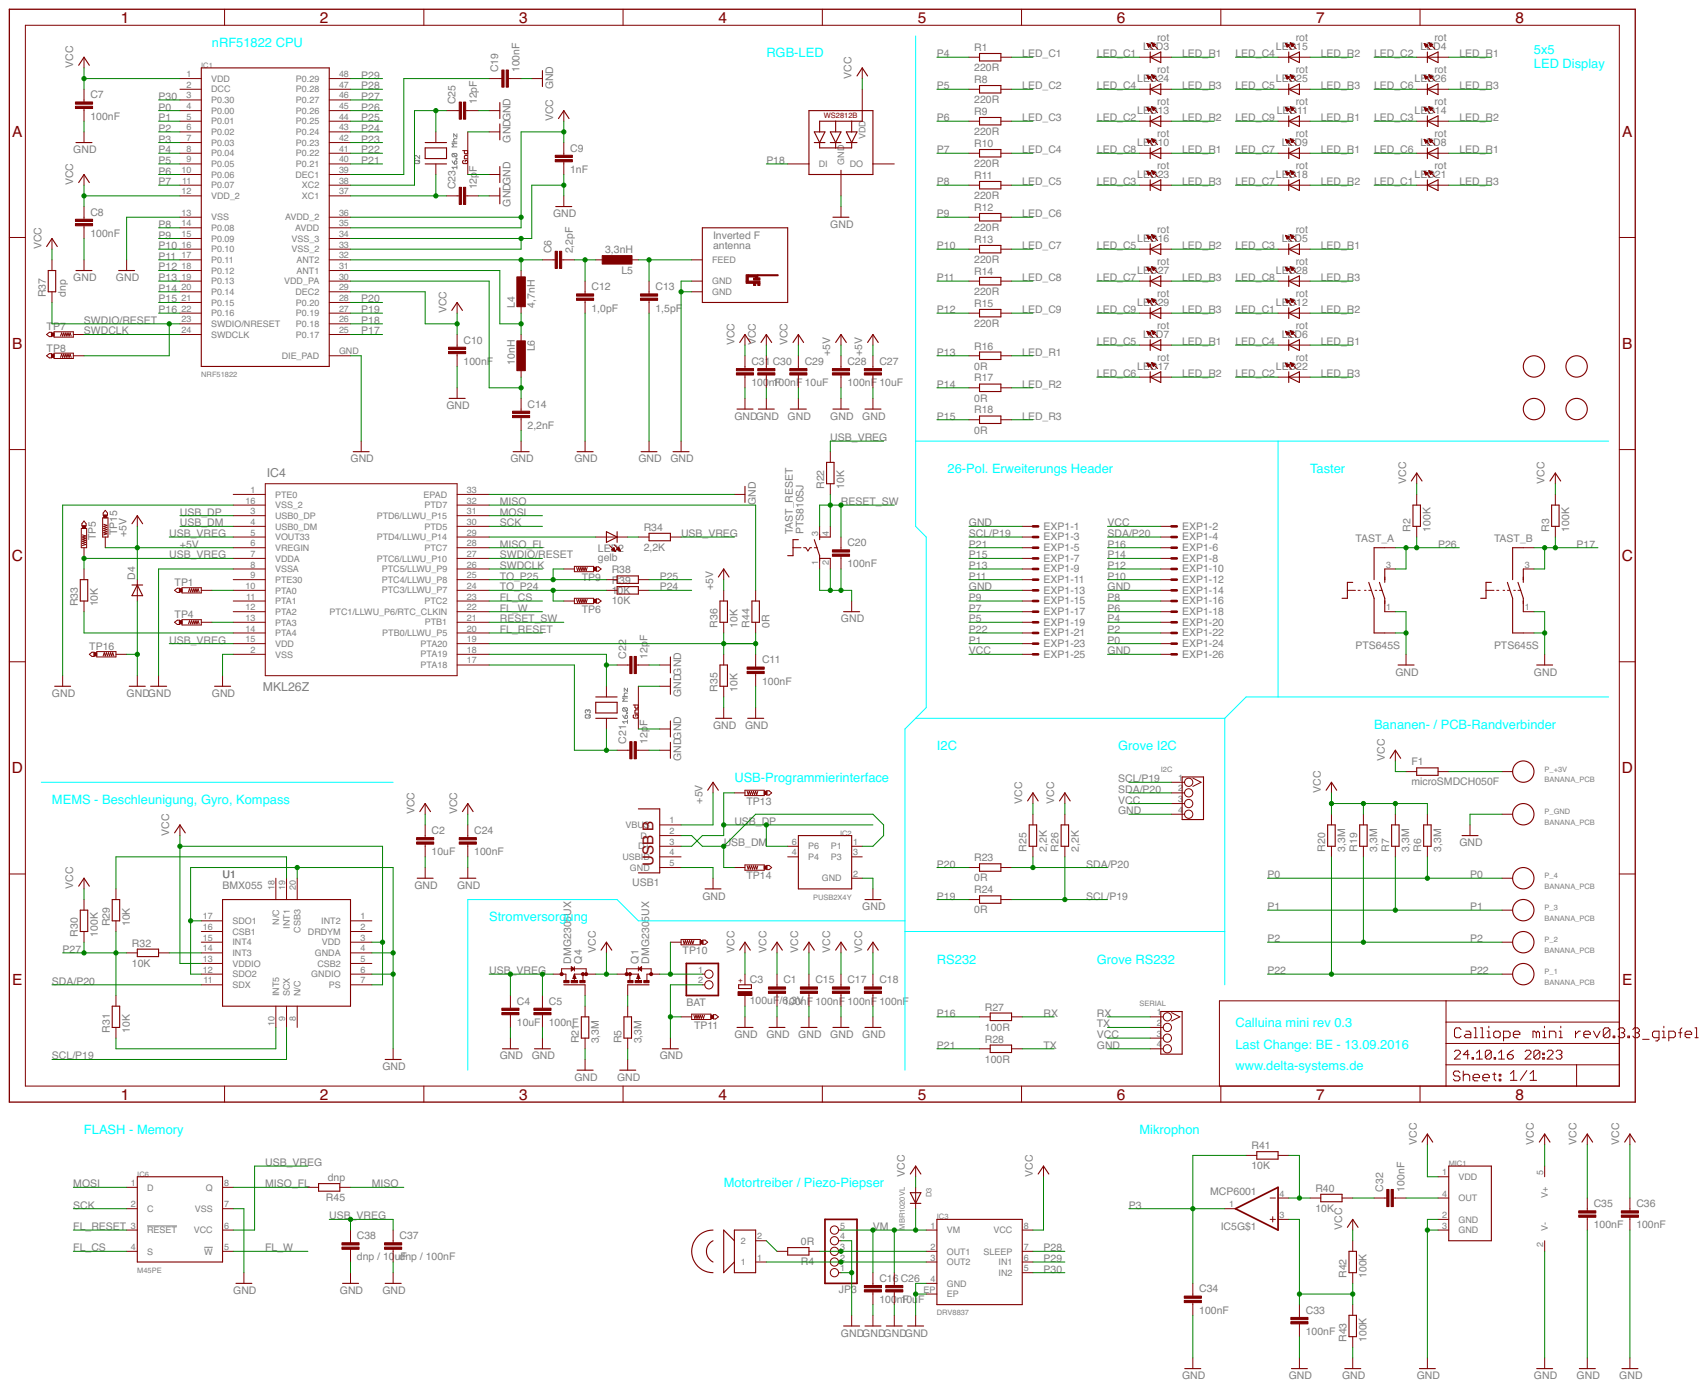
[picture p21: page 1]

24 PTC4/LLWU_P8 R39

VCC GND GND GND
