calliope-mini/calliope-mini.github.io/(commit log)

2017-04-13 update with own data
    [Calliope mini rev0.3.3_gipfel.brd, Calliope mini rev0.3.3_gipfel.sch, Calliope mini rev1.0.brd, Calliope mini rev1.0.sch]
2018-03-16 update to v1.3
    [Calliope mini rev1.3.brd, Calliope mini rev1.3.sch]
2020-08-28 Updated for REV2
    Added the new version
    [Calliope mini rev2.0.brd, Calliope mini rev2.0.sch]
2022-10-26 Updated for changes on 2.1
    [Calliope mini rev2.1.brd, Calliope mini rev2.1.sch]
